remrc/Self-Balancing-Cube/pictures/nidec.jpg

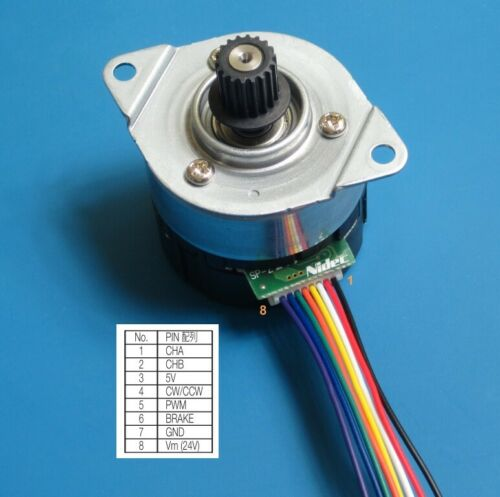
pictures/nidec.jpg
