remrc/Self-Balancing-Cube/arduino_schematic.pdf

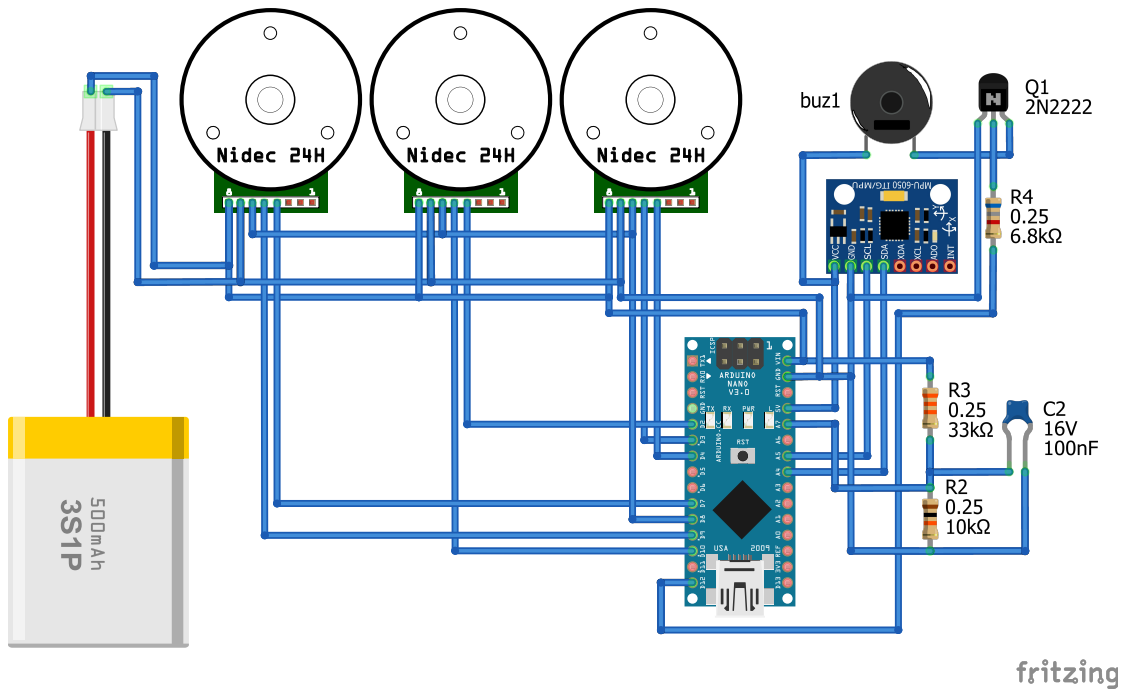
[picture p5: page 1]
