remrc/Self-Balancing-Cube/schematic.pdf

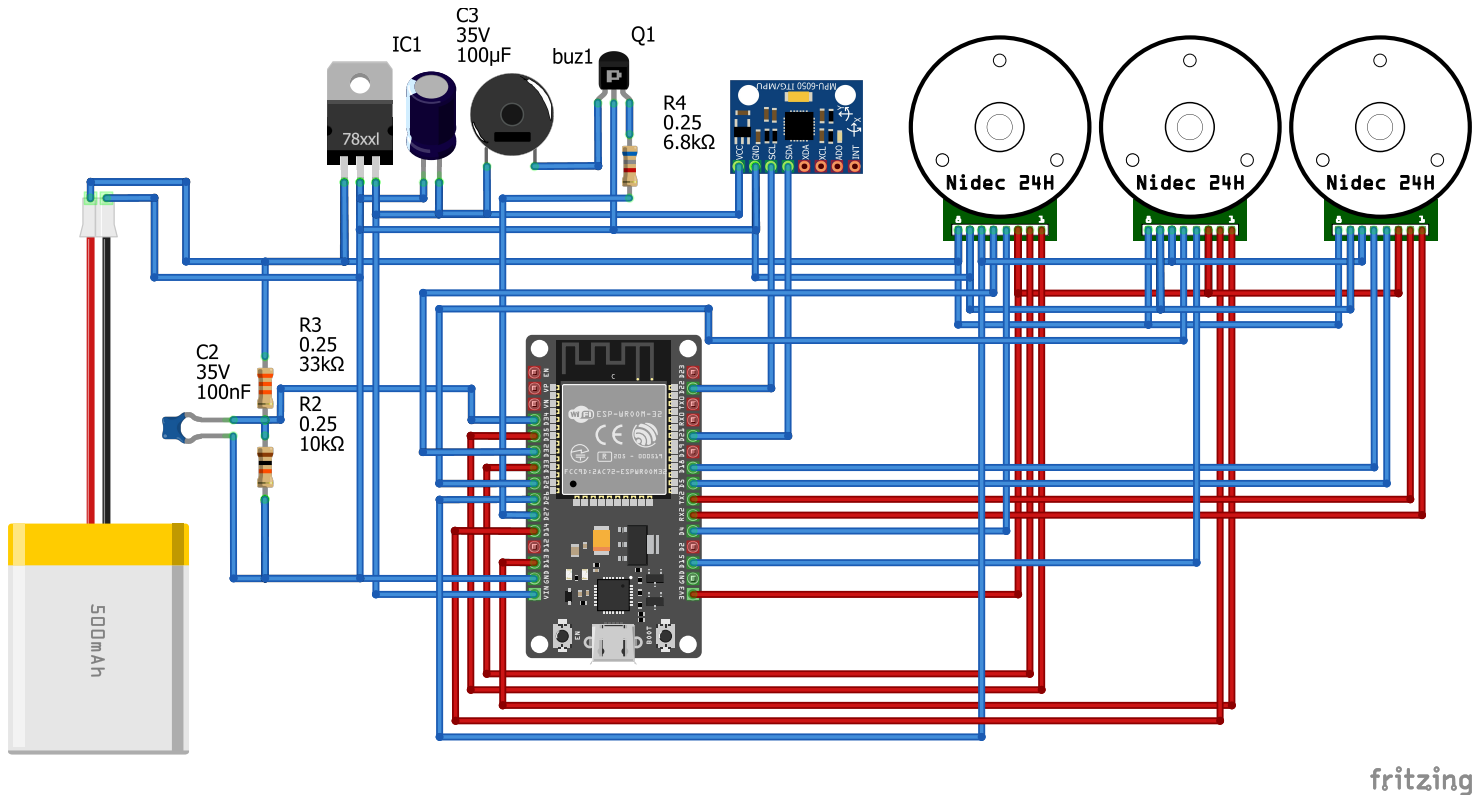
[picture p6: page 1]
