remrc/Self-Balancing-Cube/(threads)

Thread 1 (2022-05-11):

Schematic Feature Request

oscarmiike, 2022-05-11:
Hi - Would it be possible for a little schematic of your PCB? Thanks so much for sharing this project <3

joracadu, 2022-05-21:
Hello, where is it possible to consult the schematic? is it just in the video? I don't find other option, is it right?. THANKS!

remrc, 2022-05-28:
I added a schematic.

Closed 2022-05-28.

Thread 2 (2022-06-08):

Print Settings

bad1dea, 2022-06-08:
Any recommendations for printing the stls?

Infill/Perims/etc? Or it doesn't really matter.

Thread 3 (2022-06-15):

The motor is not moving

pockethmoe, 2022-06-15:
I have connected the circuit board, and the gyroscope test is normal, there is a detection sound when starting, but the motor does not move, the replacement motor failure is still the same, what is the reason?
cube.ino
pinMode(DIR1, OUTPUT);
  ledcSetup(PWM1_CH, BASE_FREQ, TIMER_BIT);
  ledcAttachPin(PWM1, PWM1_CH);
  Motor1_control(0);

Motor1_control(0);？？？

pockethmoe, 2022-06-15:
There is a strange problem in debugging today：aruiido IDE The serial port monitoring gyroscope data is similar to your value，I have modified the data according to the video and update to ESP32，But when trying to balance，But when trying to balance，In case of edge test, the same is true, but if it is not at the balance point position, the motor will not rotate，Could you provide me with an email? I'll send you the video. Please help me，thankyou。

pockethmoe, 2022-06-15:
https://user-images.githubusercontent.com/107524980/173880648-efb92002-d51a-4b31-8a54-2a4a9a9a6e40.mp4

pockethmoe, 2022-06-15:
I don't know what the problem is. The situation is the same after replacing the motor

pockethmoe, 2022-06-15:
measure brake in esp32 d26 spot  have 3.5V，The wiring is also checked according to the circuit diagram and no problem is found

remrc, 2022-06-15:
Only full speed? You didn’t mix PWM and BRAKE? Please lift the cube on the edge slowly. And show me video.

pockethmoe, 2022-06-16:
I connected according to the circuit diagram and checked the corresponding signal points of the motor. The physical wiring is normal。ESP32  32、25、18pin is PWM，26pin is brake and shared by three motors。

pockethmoe, 2022-06-16:
It's very strange. Today, the test is carried out and the function is realized!!! I don't quite understand what caused the fault before. But thank you very much for sharing the excellent project. Thank you! I'll test it later and ask again if I have any questions.

pockethmoe, 2022-06-16:
https://user-images.githubusercontent.com/107524980/173984145-3e71f89c-23d0-4cb1-a4f6-a19b679e3803.mp4

pockethmoe, 2022-06-16:
https://user-images.githubusercontent.com/107524980/173984174-c3ac30c7-d807-4d79-ae0c-58043d8e822f.mp4

remrc, 2022-06-16:
Oh, yes! I am very glad that you have achieved success.

pockethmoe, 2022-06-16:
I have another problem, adjusting settings K1 K2 K3 via Bluetooth，What is the function of this parameter，If it is modified, is it written to esp32 or reset after shutdown and restart?

pockethmoe, 2022-06-16:
Although the function has been realized from the verification, there are still many questions about the code to communicate with you. Although I have realized the function, I still want to learn more from you. Thank you for your support and help.

remrc, 2022-06-16:
K1 K2 K3 - controllers parameters. This is not need but you can change it. Yes, it resets after restart. Change it only if you know what you are doing.

pockethmoe, 2022-06-17:
Thank you very much for trying to see

Closed 2022-06-18.

Thread 4 (2022-06-28):

Not able to balance on all sides

freeifier, 2022-06-28:
Hey, I just wanted to ask if a heavier battery might be causing the balancing problems. On one site it works fine, on another it tries but seems to slow to react.

My build differs in that I am using a bigger battery maybe 2 to 3 times heavier and also a bit larger so the center of mass is higher up and also have not achieved the 70g per reaction wheel.

It worked fine on the one side but maybe it's not enough.

If you have time it would be great if you would help.
Otherwise I'll figure it out eventually and try increasing the weight first.

freeifier, 2022-07-01:
I figured it out myself, for people building this project you have to be careful when switching around motor connections, this will also impact how the cube reacts to specific axis. The best is to physically switch the motor connectors if the wrong motor spins for the given axis. Otherwise you will have to change the values which the motors will receive.

remrc, 2022-07-01:
A bigger battery is not good, but I didn't understand what you meant: "have to be careful when switching around motor connections, this will also impact how the cube reacts to specific axis"? You got the axles mixed up? Off course, this is important. But this is easy understand and swap if necessary.

freeifier, 2022-07-01:
My Motor connections differ from yours in that, that the
1->3, 2->1 and 3->2. So I changed the pin output in the code, but than also the directions was mirrored, wo I changed that in Code too. Then I got two sides Wirkung first one but removed the battery than the second worked too.

Then the 3rd side die not work at all, I Bad to change the value given to Motor1_Control from pwm_Y to -pwm_X.

Then all sides worked fine but edge point, if had to change the values too so after I understood how the cube is counteracting the forces I tested 2 Motors controlling one Y axis and then figured out X axis and then it worked.
So awesome.

remrc, 2022-07-01:
Oh, not needed to change pins in code, not needed to change motors directions. Only swap motor connections. I not declare what motor is 1, what 2 and what 3. So it is not clear which motor is on which side of the cube. But it is easy to determine. Only swap motor connections!

freeifier, 2022-07-01:
Yeah, but the cables wouldn't fit otherwise, so I took this path the nice thing is that I understand the code and know where everything is, learned also about PID controllers on the way so nice excersise.
It is also nice code solid structure found the stuff quite well.

remrc, 2022-07-01:
Yes, understanding what is where - good. But there is no PID here...

freeifier, 2022-07-01:
Ok it seemed that way not that familiär with pid bit you have a proportional term than one which responds to Motorspeed and one Which you can tune with I thought it might stand for Intergral.

What type of controller is it then ?

Closed 2022-07-01.

Thread 5 (2022-08-20):

schematic missing information

SnippetsUnlimited, 2022-08-20:
The schematic shows use of a transistor for the buzzer but there is no transistor number mentioned on the schematic. Can you suggest the transistor number/model used and the pin connections. I am just a hobbyist and do not have knowledge enough to know by myself, what kind of transistor I should utilize here.

Thanks-

remrc, 2022-08-22:
You can use PN2222 or something similar (n-p-n).

SnippetsUnlimited, 2022-08-24:
I do not have PN2222 available but but it seems that I can use the available alternative 2N2222.

Thanks for the help!!

Closed 2022-08-24.

Thread 7 (2023-09-16):

esp32 q1 transistor code

Zed-CSP, 2023-09-16:
Can you elaborate on the q1 transistor 'p' type for the esp32 schematic? what is its code and what type of transistor is it?

Zed-CSP, 2023-09-16:
found issue was addressed

Closed 2023-09-16.

Thread 9 (2024-08-02):

Regulator adjustment over BT missing from esp32_cube_enc code

alekoy, 2024-08-02:
Adjusting the PIDs is not possible over BT when using the encoder-program, as there is no coding for it,
Had to adjust the K and eK-values in the ESP21.h file and re-flash the esp for each adjustment.

I tried tuning it for some time before I discovered this, so this comment is meant as a heads up for anyone trying to adjust it using the method shown in the youtube-video.

remrc, 2024-08-16:
Yes, I removed this part of code.

Thread 10 (2024-08-14):

Question about PWM coding

EagleYK, 2024-08-14:
Hi, I saw in the code below you put 255-pwm as final results. Does it mean Nidec motor sets lower PWM but getting high motor speed?
 >>> pwmSet(PWM1_CH, sp > 255 ? 255 : 255 - sp);
THX a lot.

remrc, 2024-08-16:
Nidec PWM is inverse.

EagleYK, 2024-08-19:
> Nidec PWM is inverse.

Thanks a lot it really helps.

Closed 2024-08-16.

Thread 11 (2024-08-22):

Schematics

OpenSourceDistilling, 2024-08-22:
I think the transistor is wired correctly in the Nano schematic and incorrectly on the other one.

I believe it should be an N-type transistor, wired to the middle pin with the 6.8K ohms resistor to D27 instead of to ground.

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

remrc, 2024-09-02:
I didn't write anywhere in the ESP32 schematic that it's a 2N2222. I use different transistor. But if you're using a 2N2222, yes, the Nano schematic is correct.
I drew it like mine and I didn't think there would be such a problem... It's strange... Connecting the buzzer is the simplest thing, how to do it can be found on the Internet in 1 minute.

malebuffy, 2024-10-31:
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

Would you have the fritzing file you could share with me?

Thread 12 (2024-10-18):

Compilation error: 'ledcSetup' was not declared in this scope

jcleek, 2024-10-18:
I am trying to upgrade my cube from your first version and getting an error when I try to upload to the ESP32. I have made it through most of the issues I encountered but this one I am unable to resolve so hoping you can point me in the right direction.

My search led me to an upgrade thread for arduino ESP32 for migration from 2.0 - 3.0 that aligns with the timeline for your code release date so maybe that's it. I just don't know how to resolve it.
 
```
C:\Downloads\Self-Balancing-Cube-main\esp32_cube_enc\esp32_cube_enc.ino: In function 'void setup()':
C:\Downloads\Self-Balancing-Cube-main\esp32_cube_enc\esp32_cube_enc.ino:55:3: error: 'ledcSetup' was not declared in this scope
   55 |   ledcSetup(PWM1_CH, BASE_FREQ, TIMER_BIT);
      |   ^~~~~~~~~
C:\Downloads\Self-Balancing-Cube-main\esp32_cube_enc\esp32_cube_enc.ino:56:3: error: 'ledcAttachPin' was not declared in this scope; did you mean 'ledcAttach'?
   56 |   ledcAttachPin(PWM1, PWM1_CH);
      |   ^~~~~~~~~~~~~
      |   ledcAttach

exit status 1

Compilation error: 'ledcSetup' was not declared in this scope
```

remrc, 2024-10-18:
Yes, use ESP32 2.*.

Closed 2024-11-18.

Thread 13 (2024-10-23):

Motor Pinout

r3dk1ngs, 2024-10-23:
Hi,
I'm having issues getting my motors to run.  So far I havent been able to get them to respond to any test codes.  The motors I bought appear identical to the motor in the photo you uploaded, but the motors I have look to have an opposite pinout from the one in your photo.  When I remove the housing from the motor, the connector is labeled with an "8" on the side that you have labeled "1" and vise versa.  Can you confirm the connections that worked for your motor?  I connected my motor based on the pin labels on my motor and worry that they may be backwards now.  Thanks!

Closed 2024-10-24.

Thread 15 (2024-11-18):

Encoder Voltage Incorrect in Schematic

mpaw, 2024-11-18:
In the schematic you have the power supply of the encoder on the Nidec motor connected to 3.3V on the ESP32. Power supply of the encoder should be 5V.

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

remrc, 2024-11-18:
Yes, but encoders work fine with 3.3V.

Closed 2024-11-18.

Thread 16 (2024-12-03):

'ledcSetup' was not declared in this scope

manuelchaves, 2024-12-03:
'ledcSetup' was not declared in this scope

jcleek, 2024-12-04:
https://github.com/remrc/Self-Balancing-Cube/issues/12

Closed 2024-12-04.

Thread 17 (2024-12-04):

Battery voltage question

jcleek, 2024-12-04:
Battery buzzer isn't going off at low voltage. Comment in code says "value 204 must be selected by measuring battery voltage!" but I am unsure what this measurement is.

remrc, 2024-12-04:
This value should be selected so that the beeping begins at ~9.5V.

jcleek, 2024-12-04:
Sorry, I mean where did you get the value "204"? What is that?

remrc, 2024-12-04:
Of course, by changing the voltage and printing measured value.

Closed 2024-12-05.

Thread 20 (2025-02-10):

Different version of Nidec 24H

krupis, 2025-02-10:
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

I have a slightly different version of Nidec 24H motor and curious whether anyone managed to run this project on this version motor and what changes are required?

Additionally, based on your code I see you use PWM to control the motors. Is there any particular reason why you use PWM instead of PFM (Pulse frequency modulation).

Wherever I read about this motor, it specifies that it needs PFM (1000HZ-26000HZ) to control motor speed.

Thanks in advance for any clarifications!

remrc, 2025-02-10:
There is a different motor here. I don't have one and can't give any advice.

Closed 2025-03-18.

Thread 21 (2025-03-17):

How to calibrate the arduino version of the self balancing cube.

gijsoman, 2025-03-17:
Dear remrc,

Thank you for creating this awesome project and putting it on the internet for us to make ourselves.

I am a bit of a noob so be warned.

I am stuck at the point where I uploaded the arduino code to my arduino nano and you are saying to connect to it over bluetooth. As far as I know I cant connect because the arduino nano doesn't have bluetooth. Can you explain how the calibration process goes with an arduino because the cube is there, its just not balancing yet :),

Thanks again and hopefully you can help me out.

remrc, 2025-03-18:
You can always connect a Bluetooth module.

Closed 2025-03-18.

Thread 23 (2025-06-30):

Schematic of system with the nano

rpcoe, 2025-06-30:
Shouldn't there still be a need for the 5 volt regulator?

rpcoe, 2025-06-30:
Thanks. I didn't realize that.

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

Closed 2025-07-02.
