remrc/Self-Balancing-Cube/(commit log)

2022-07-11 motors test added
2022-11-07 Arduino nano version
